HellCoders/Rutgers-ECE-Spring-2018-Capstone---Group-36/Block Diagram/Device_Enclosure_Draft.jpg

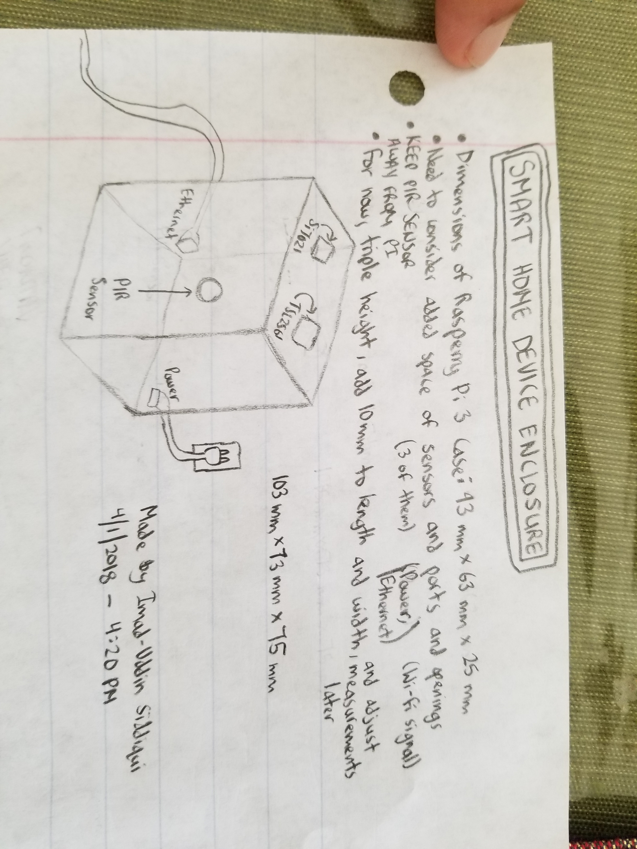
Block Diagram/Device_Enclosure_Draft.jpg
