HellCoders/Rutgers-ECE-Spring-2018-Capstone---Group-36/Meeting Notes/Before Spring Break meetings/Meeting2.jpeg

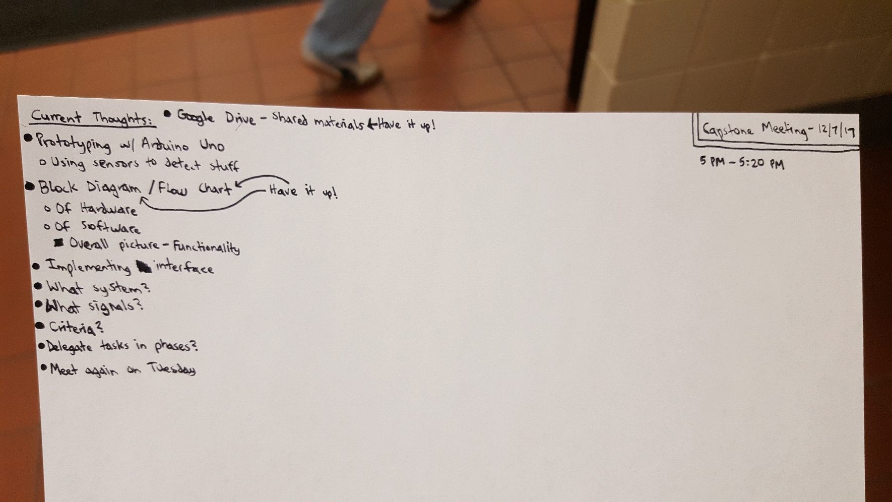
Meeting Notes/Before Spring Break meetings/Meeting2.jpeg
