HellCoders/Rutgers-ECE-Spring-2018-Capstone---Group-36/Meeting Notes/Meeting 13 Notes.docx

Capstone Meeting 13

Date: 3/13/2018

Time: 5:15 PM to 5:30 PM

Update:

- Finished sampling and piping
- Thorson currently working on the Schmitt trigger on the website and setting everything up for it
- Phase 1 mostly complete

Plan:

- Finish report and think of packaging
- Make PCB for our sensors
  - Make Eagle libraries for the three sensors we’re using
    - Schematic symbol and footprint
  - We’ll discuss more on Friday
