HellCoders/Rutgers-ECE-Spring-2018-Capstone---Group-36/Meeting Notes/Meeting 14 Notes.docx

Capstone Meeting 14

Date: 3/16/2018

Time: 8:00 PM to 8:15 PM

Update:

- Finished sampling and piping
- Thorson currently working on the Schmitt trigger on the website and setting everything up for it
- Phase 1 mostly complete
- Eagle libraries made for the Si7021 and TSL2561
- Interim report mostly done

Plan:

- Think of packaging
- Make PCB for our sensors
  - Make Eagle libraries for our sensors and put them into one board, both in Eagle and in life
    - Schematic symbol and footprint
  - First do it with one sensor, Pi, and two pull up resistors on I2C lines and then build it up
  - Make device and library for PIR sensor as well
