HellCoders/Rutgers-ECE-Spring-2018-Capstone---Group-36/Meeting Notes/Before Spring Break meetings/Meeting 3.docx

Google Hangouts

Attendees - Samuel, Neil, Imad

Time - Approx 1hr 30min

Topics - Parts, schematic, block diagram

- Use mosfet to interface the LEDs for device display like power, communication etc.
- Create new block diagram with part numbers
- Create schematic on eagle
- Figure out voltage requirements for sensors and power supply needed
- Schematic due 1/12/18
- Meeting next Monday/Tuesday
