HellCoders/Rutgers-ECE-Spring-2018-Capstone---Group-36/Resources/Example sources for drivers.docx

https://github.com/adafruit/Adafruit_CircuitPython_TSL2561/blob/master/adafruit_tsl2561.py

https://github.com/seanbechhofer/raspberrypi/blob/master/python/TSL2561.py

https://github.com/ControlEverythingCommunity/TSL2561/blob/master/Python/TSL2561.py

http://www.raspberryconnect.com/hardware-add-ons/item/324-tsl2561-luminosity-sensor-ir-and-visible-light
