HellCoders/Rutgers-ECE-Spring-2018-Capstone---Group-36/POSTER/poster_template.pptx

Title of The Project Goes Here

Student Name1, Name 2, and Name 3
{x, x, x, x}@scarletmail.rutgers.edu
Advisor: Prof.

Methodology (put some figure)
- Step 1
- Step 2

Goal

- Goals

Methodology

Methodology contd…
- Step 3
- Step 4

Motivations and Objectives

- Motivations
  - A
  - B
- Objectives
  - A
  - B

Results

Results (put some figure)
- Result 1
- Result 2
- Result 3

Results contd…
- More results
- Discussion

Research Challenges

- Challenge 1
- Challenge 2
- Challenge 3

Acknowledgement

We would like to thank…

References

[1]
[2]
[3]
