HellCoders/Rutgers-ECE-Spring-2018-Capstone---Group-36/Schematic/Adafruit TSL2561 Schematic - Notes.PDF

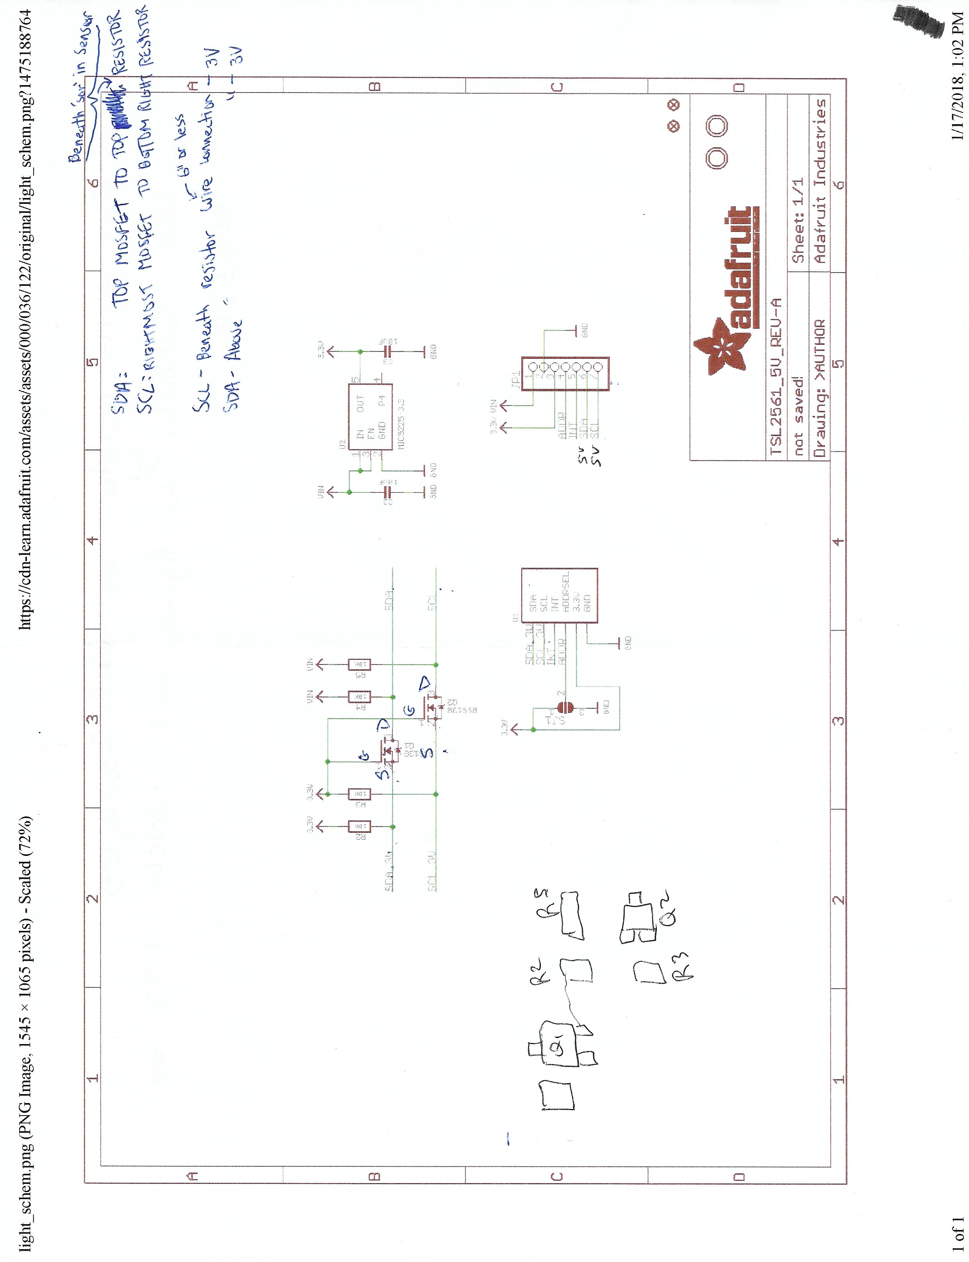
[picture p31: page 1]
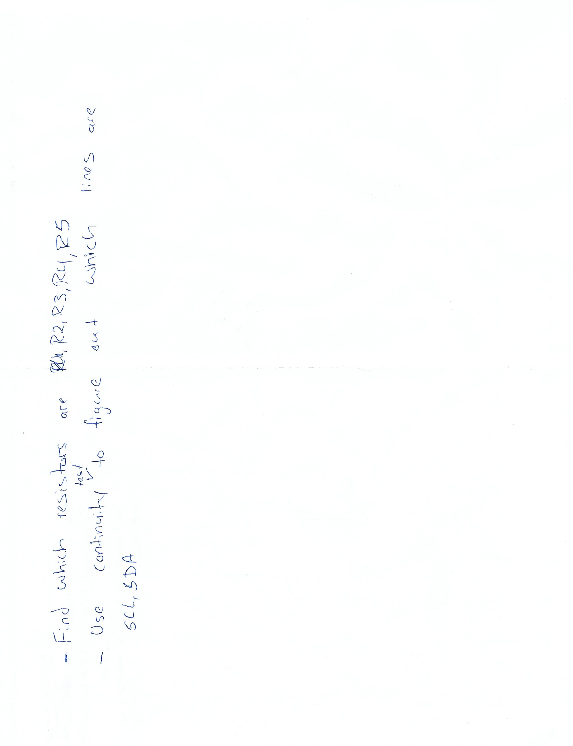
[picture p32: page 2]
