HellCoders/Rutgers-ECE-Spring-2018-Capstone---Group-36/Block Diagram/Block Diagram.PDF

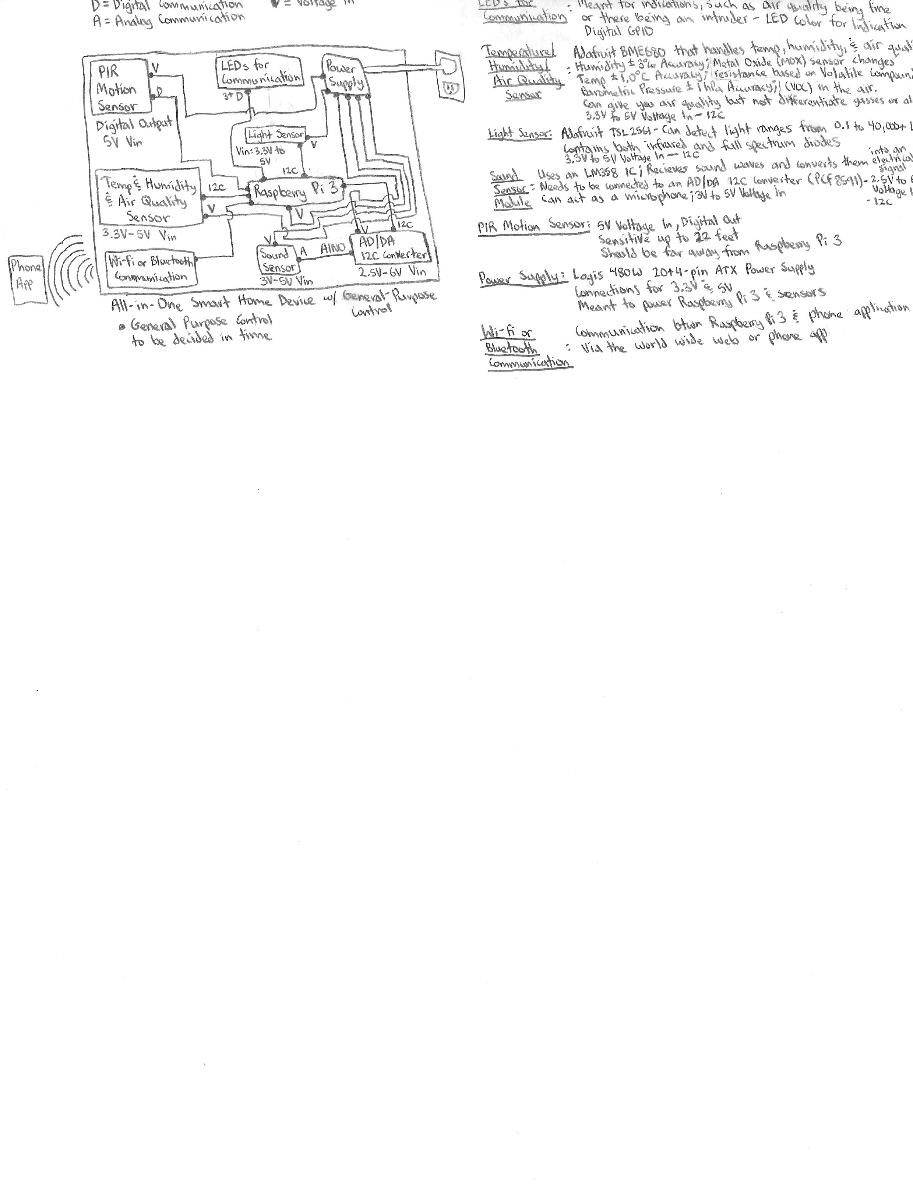
[picture p33: page 1]
