HellCoders/Rutgers-ECE-Spring-2018-Capstone---Group-36/Block Diagram/Rough draft Block Diagram.pdf

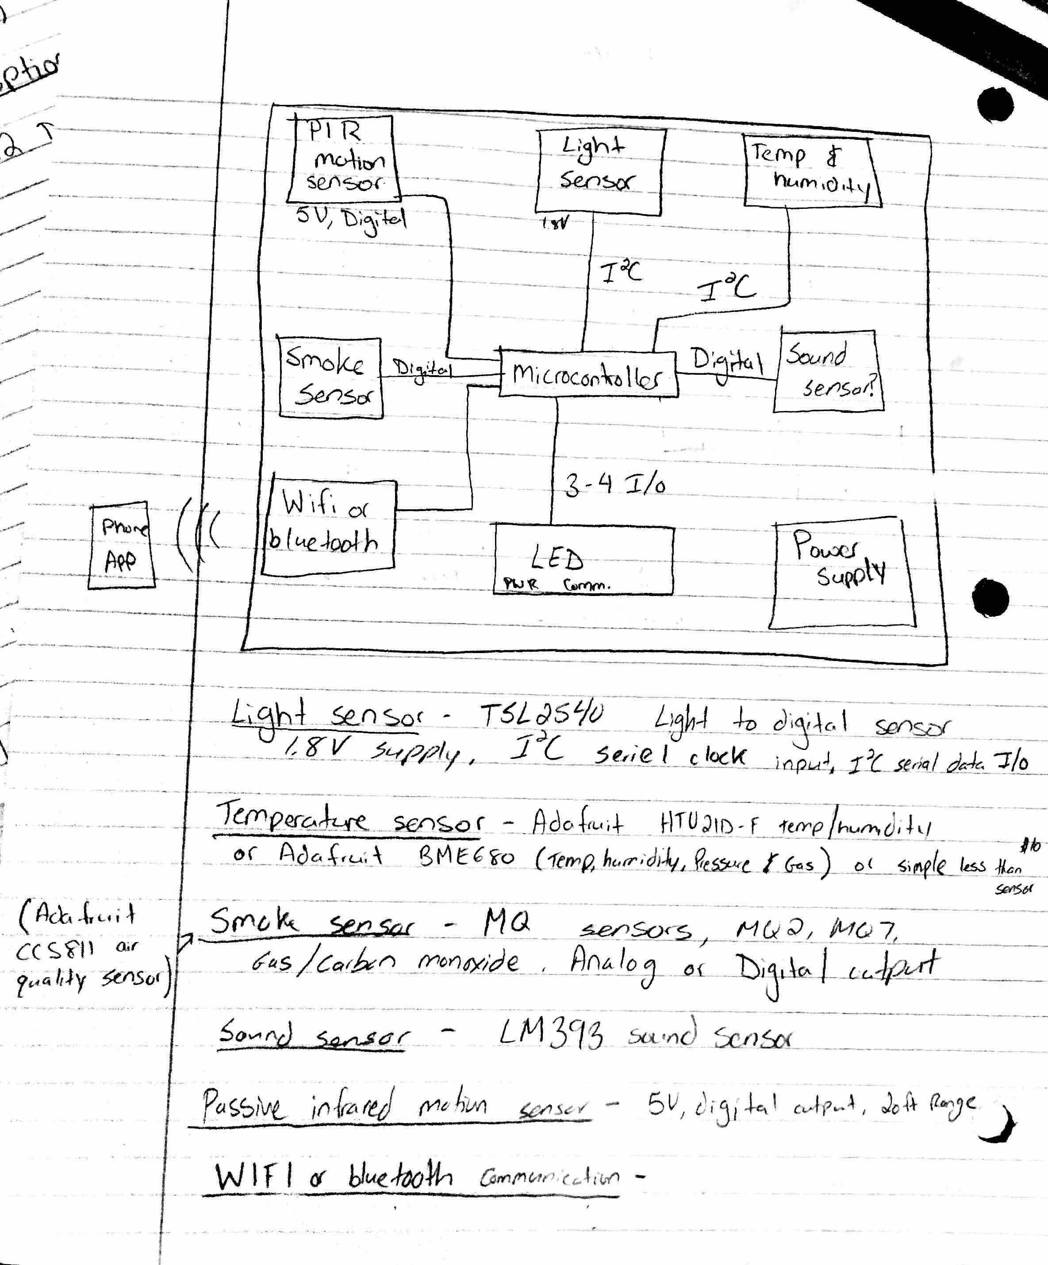
[picture p34: page 1]
