HellCoders/Rutgers-ECE-Spring-2018-Capstone---Group-36/Schematic/Light Sensor Schematic.JPG

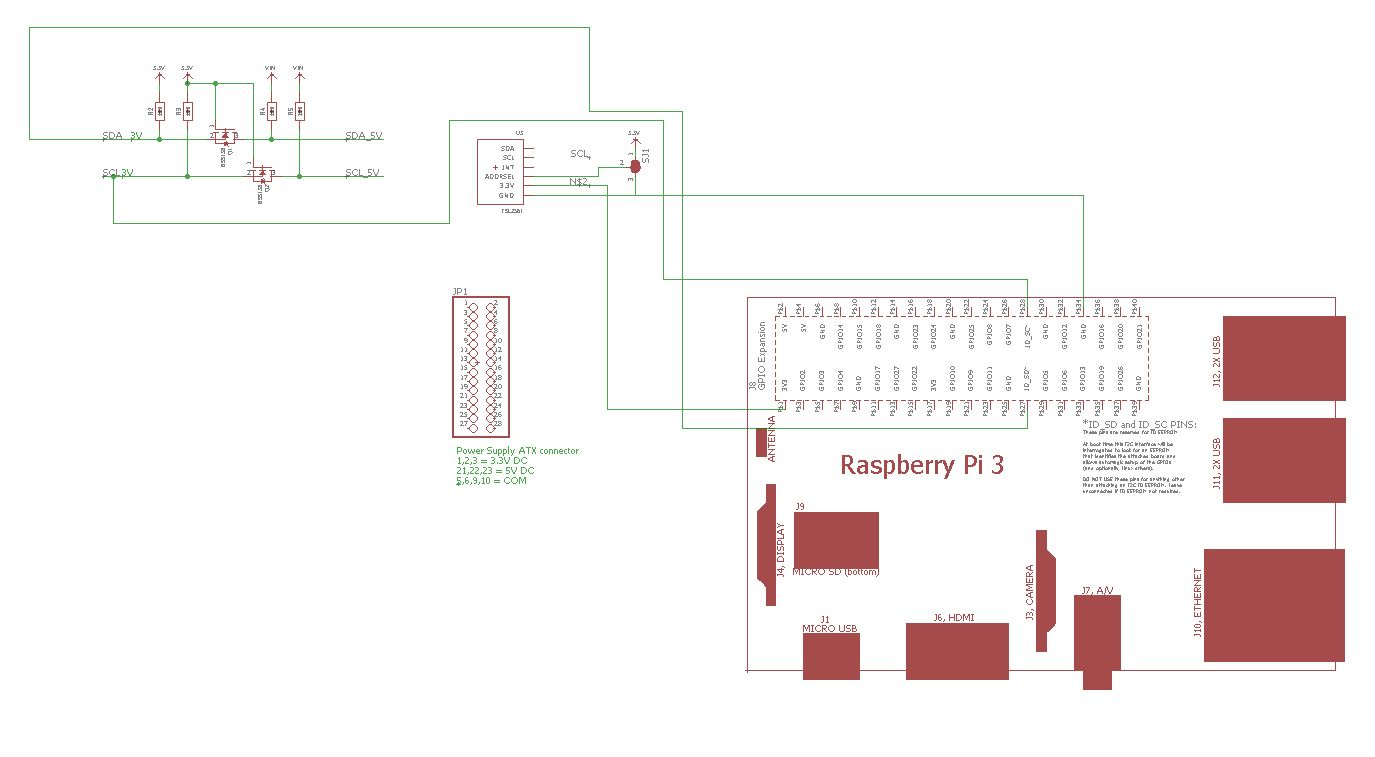
Schematic/Light Sensor Schematic.JPG
