HellCoders/Rutgers-ECE-Spring-2018-Capstone---Group-36/Schematic/Schematic.JPG

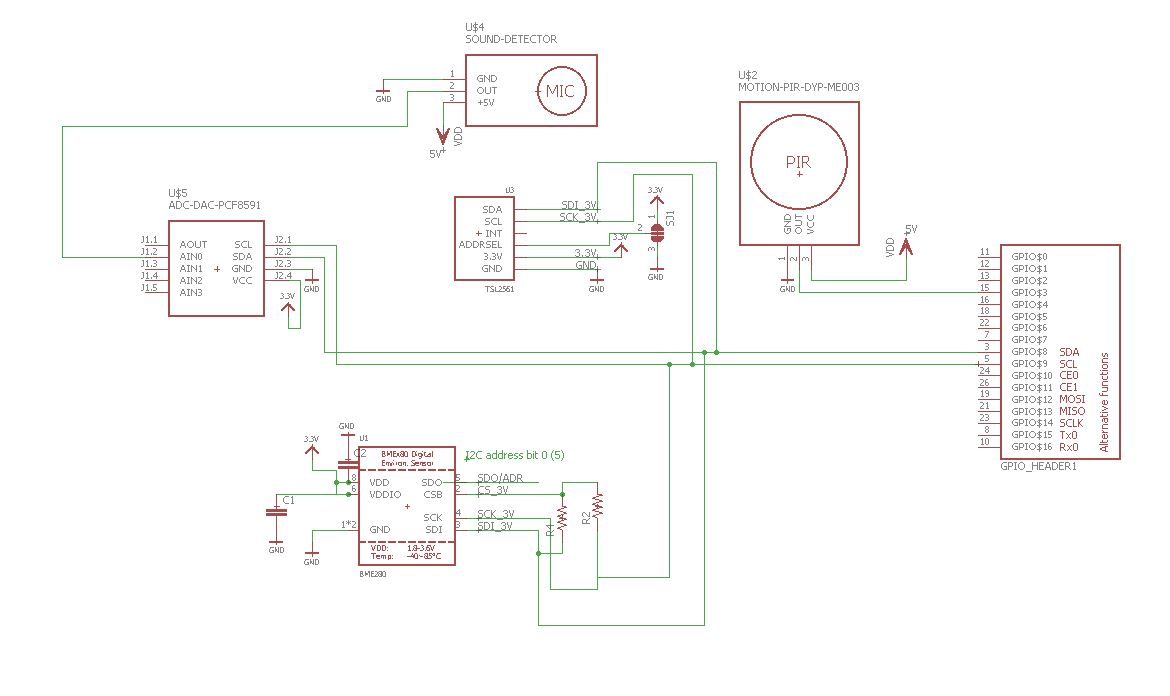
Schematic/Schematic.JPG
