HellCoders/Rutgers-ECE-Spring-2018-Capstone---Group-36/Sensor Webpage/sensor-704x900.png

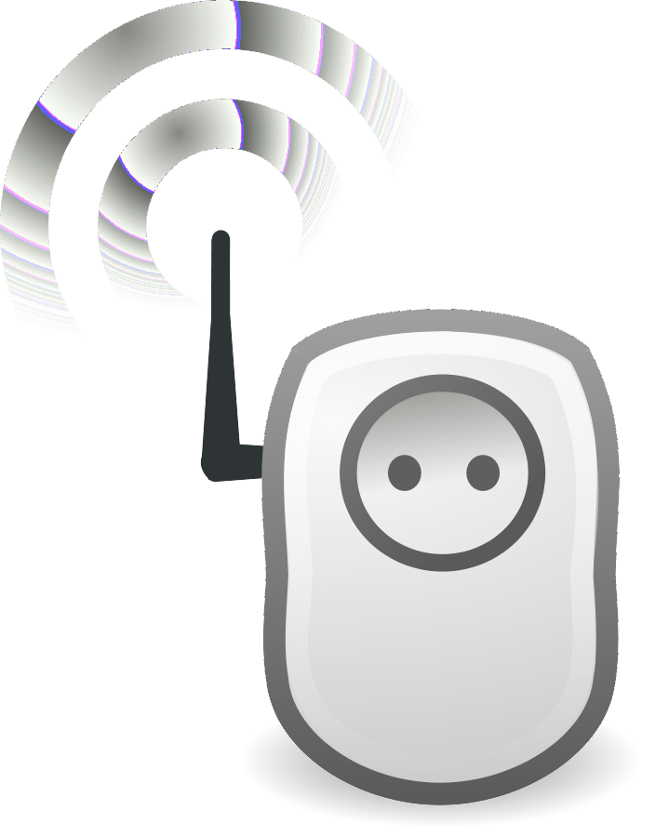
Sensor Webpage/sensor-704x900.png
