HellCoders/Rutgers-ECE-Spring-2018-Capstone---Group-36/TSL2561/PCB/Capture23.JPG

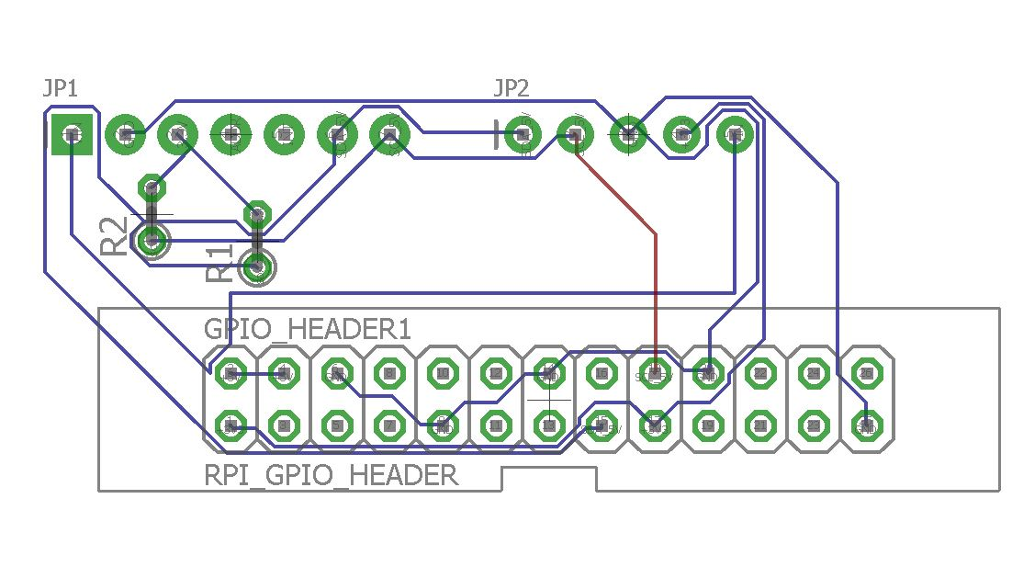
TSL2561/PCB/Capture23.JPG
