HellCoders/Rutgers-ECE-Spring-2018-Capstone---Group-36/TSL2561/PCB/TSL2561_5V_REV-A - Copy.brd

## EAGLE design TSL2561/PCB/TSL2561_5V_REV-A - Copy.brd (2021-06-09)

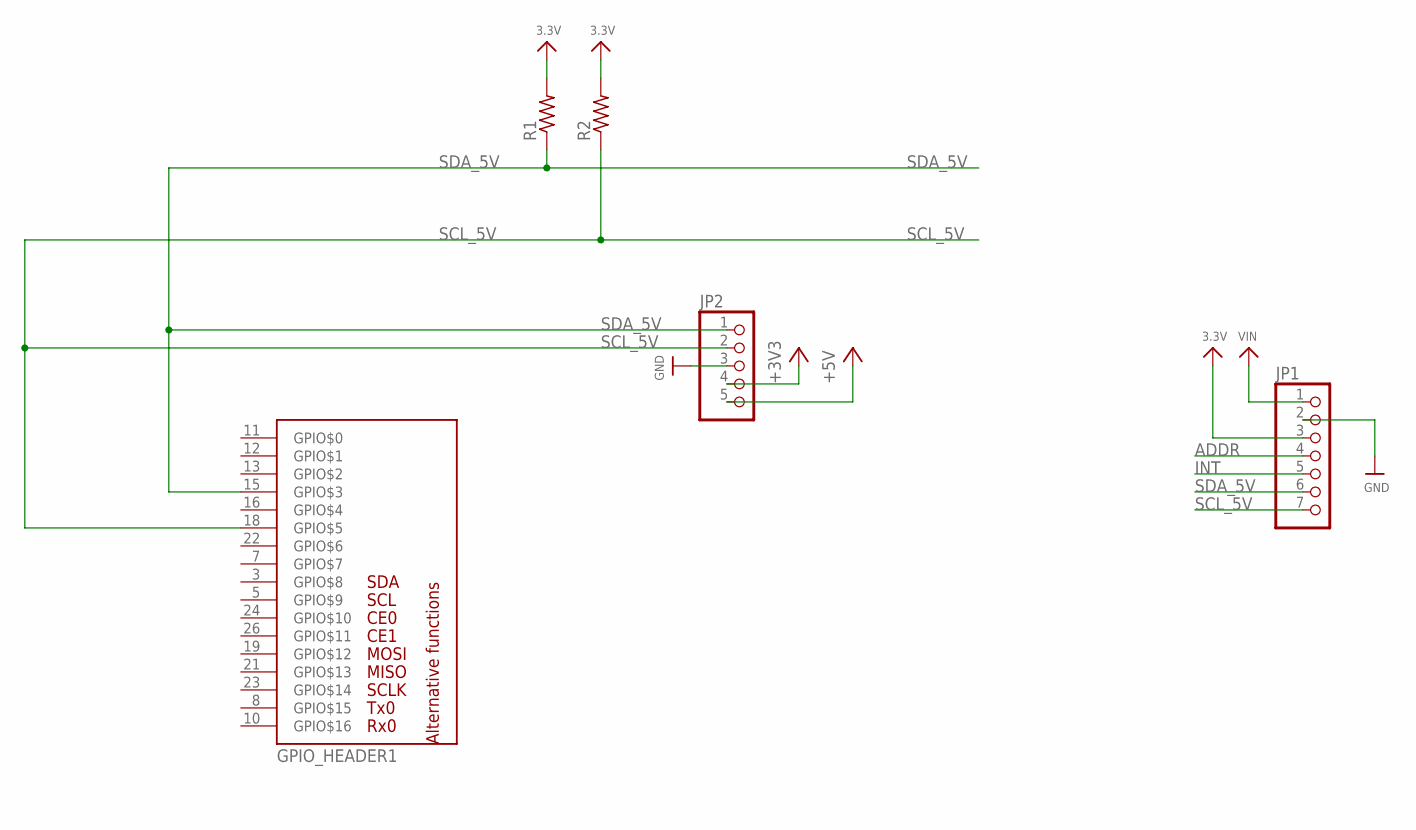
[picture p41: schematic TSL2561_5V_REV-A - Copy.sch]

Parts:
GPIO_HEADER1: RPI_GPIO_HEADER; 2X13
JP1: HEADER-1X7THICKER; 1X07_ROUND_76
JP2: HEADER-1X570MIL; 1X05_ROUND_70
R1, R2: R-US_0204/2V; 0204V

Connections:
3.3V: JP1.3, R1.2, R2.2
+3V3: GPIO_HEADER1.1 (+3V3), GPIO_HEADER1.17 (+3V3), JP2.4
+5V: GPIO_HEADER1.2 (+5V), GPIO_HEADER1.4 (+5V)
ADDR: JP1.4
GND: GPIO_HEADER1.6 (GND), GPIO_HEADER1.9 (GND), GPIO_HEADER1.14 (GND), GPIO_HEADER1.20 (GND), GPIO_HEADER1.25 (GND), JP1.2, JP2.3
INT: JP1.5
SCL_5V: GPIO_HEADER1.18 (GPIO$5), JP1.7, JP2.2, R2.1
SDA_5V: GPIO_HEADER1.15 (GPIO$3), JP1.6, JP2.1, R1.1
VIN: JP1.1, JP2.5

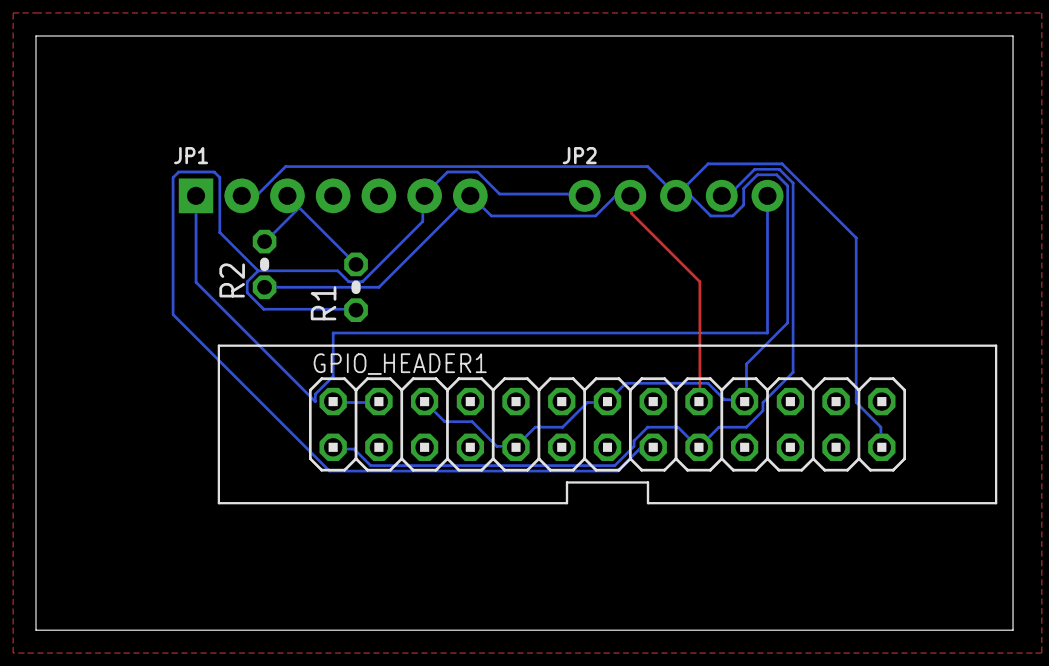
[picture p42: board TSL2561_5V_REV-A - Copy.brd from above]

Board: 2 copper layers, 54.3 x 33.0 mm, 5 parts (0 on the bottom side), 7 nets.
