HellCoders/Rutgers-ECE-Spring-2018-Capstone---Group-36/Schematic/Capstone Schematic.sch

## EAGLE design Schematic/Capstone Schematic.sch (2021-06-09)

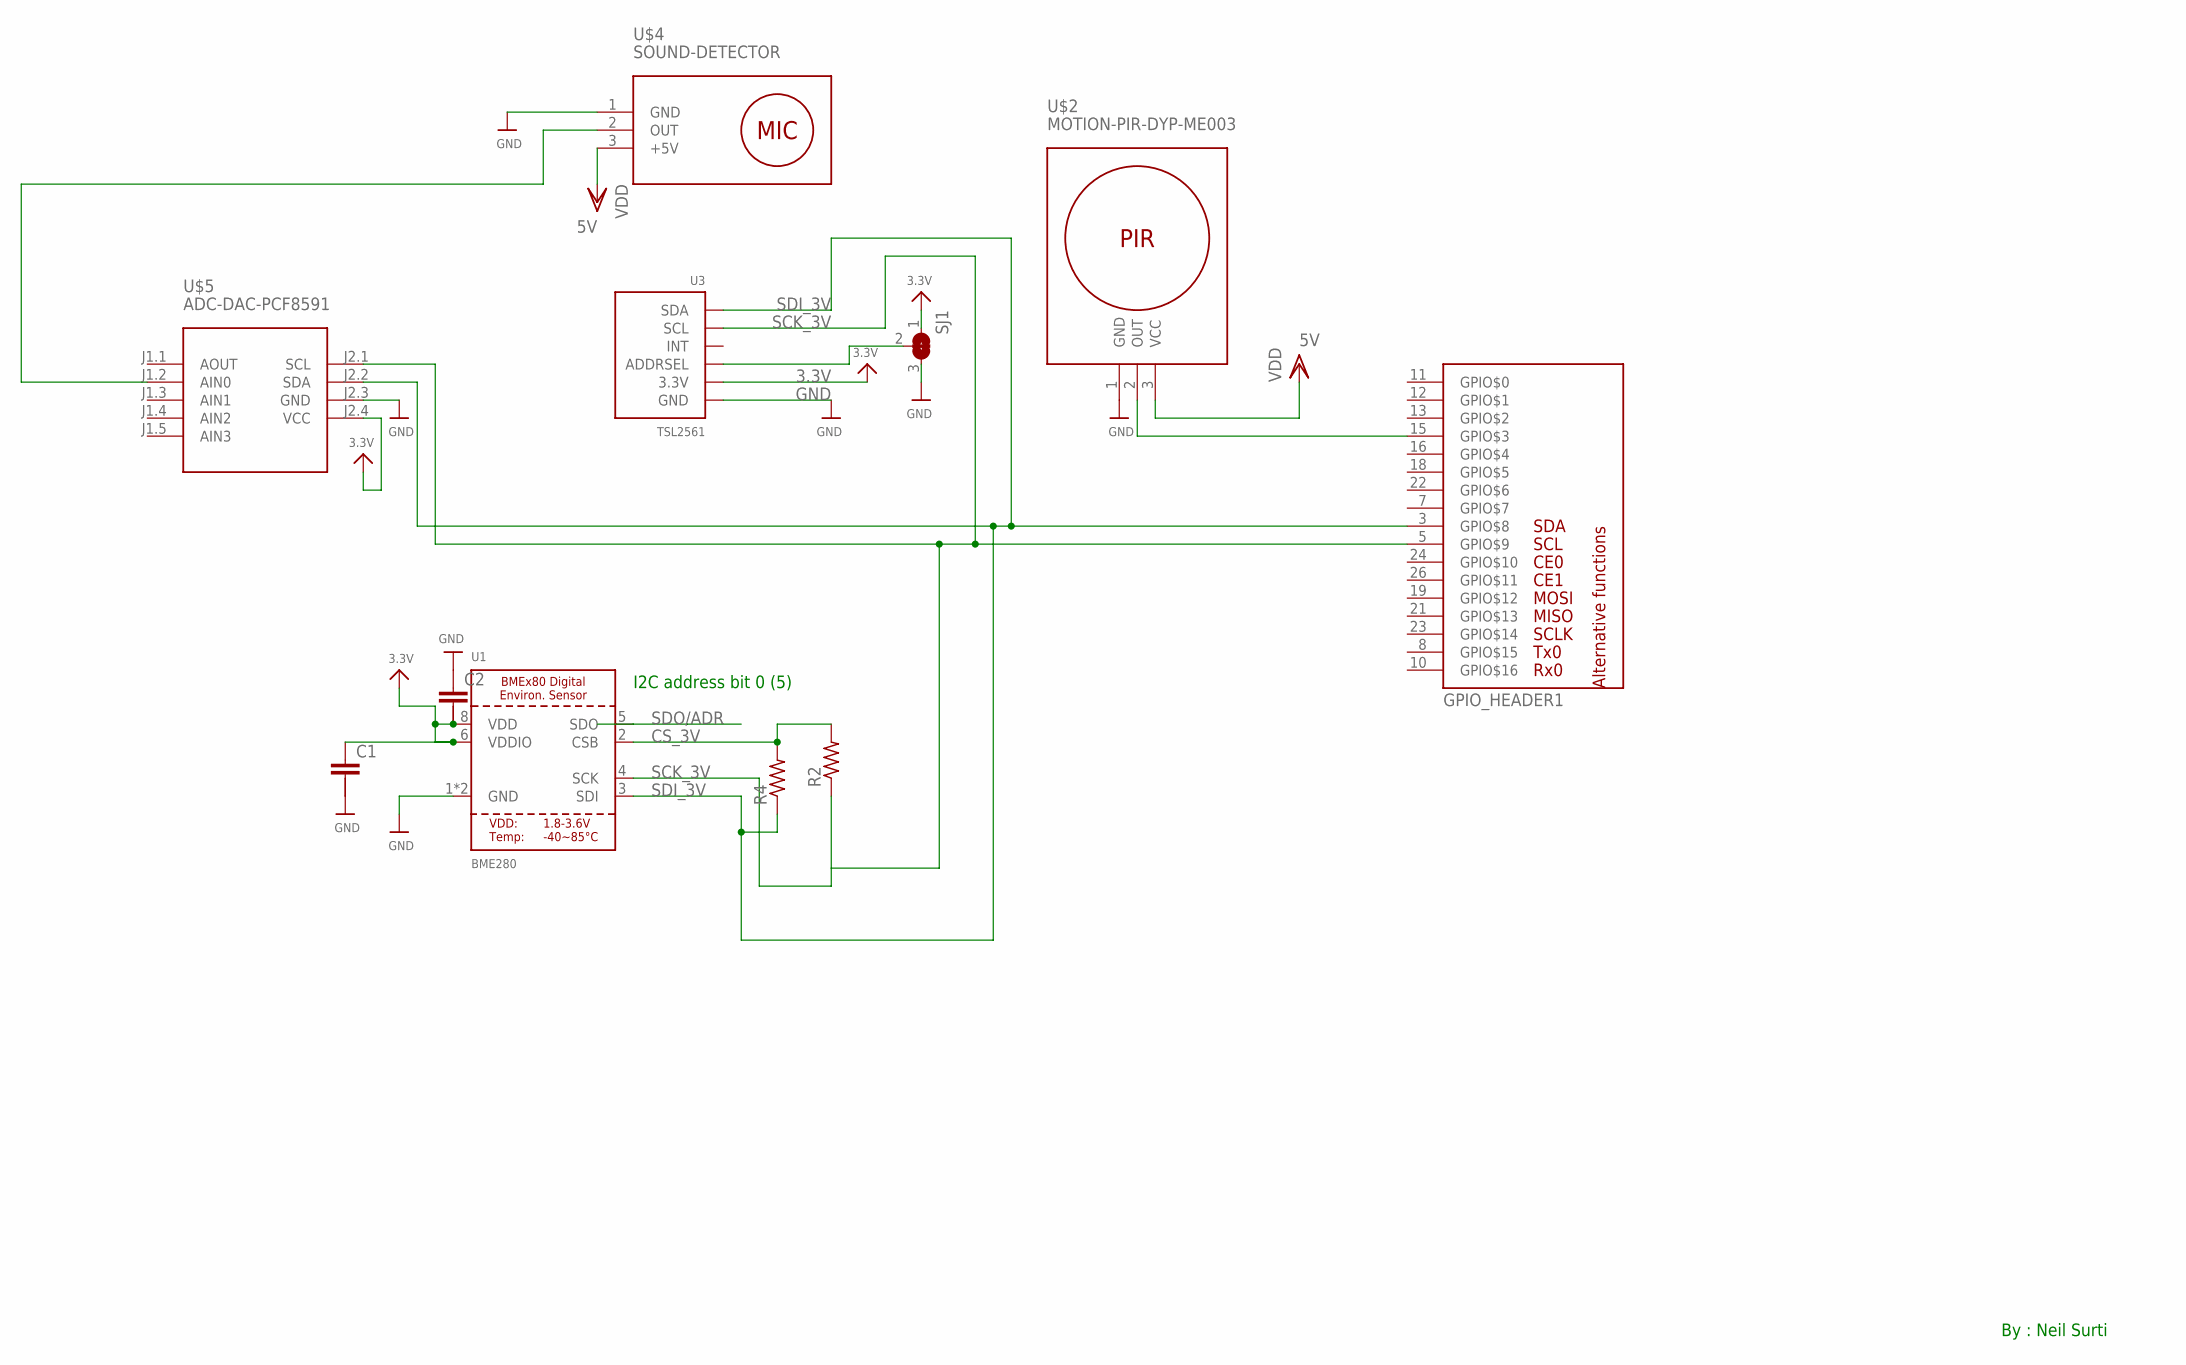
[picture p43: schematic Capstone Schematic.sch]

Parts:
C1, C2: C-10-15/6; C10-15B6
GPIO_HEADER1: RPI_GPIO_HEADER; 2X13
R2, R4: R-US_0309/12; 0309/12
SJ1: SOLDERJUMPER_2WAY; SOLDERJUMPER_2WAY_OPEN_NOPASTE
U1: BME280
U3: TSL2561; TSL2561_FN
U$2: MOTION-PIR-DYP-ME003
U$4: SOUND-DETECTOR
U$5: ADC-DAC-PCF8591

Connections:
3.3V: C1.1, C2.2, SJ1.1, U1.6 (VDDIO), U1.8 (VDD), U3.VDD (3.3V), U$5.J2.4 (VCC)
CS_3V: R2.2, R4.2, U1.2 (CSB)
GND: C2.1, SJ1.3, U1.1 (GND), U3.VSS (GND), U$4.1 (GND), U$5.J2.3 (GND)
unnamed: SJ1.2, U3.ADR (ADDRSEL)
unnamed: U$4.2 (OUT), U$5.J1.2 (AIN0)
unnamed: GPIO_HEADER1.15 (GPIO$3), U$2.2 (OUT)
SCK_3V: GPIO_HEADER1.5 (GPIO$9), R2.1, U1.4 (SCK), U3.CLK (SCL), U$5.J2.1 (SCL)
SDI_3V: GPIO_HEADER1.3 (GPIO$8), R4.1, U1.3 (SDI), U3.DATA (SDA), U$5.J2.2 (SDA)
SDO/ADR: U1.5 (SDO)
VDD: U$2.3 (VCC)

Notes on the sheet:
I2C address bit 0 (5)
By : Neil Surti
